ayushmk7/Dhyaan_HackMIT2026/DEMO_RUNBOOK.md

# Demo runbook — Sunday 11:00 AM

The demo beat sheet, boot order, and recovery moves. Written at 5 AM Sunday and
corrected at 14:30 after a full dress rehearsal; anything marked ⚠ needs a human
step first.

**`./demo.sh check` answers "am I ready" in ten lines.** Run it first, and again
after anything moves. `./demo.sh` with no argument lists what else it does
(`reset` between takes, `fall` without the band, `tunnel`, `survey`, `camera`).

## The demo script

0. **Camera tab → Turn the camera on.** The switch in the app really starts the
   vision worker on the hub: it opens the webcam and runs the whole cascade, and
   the pane shows the same annotated frame the hub's own window draws. Pre-warm
   it before you present (`./demo.sh camera on`) — a cold start spends ~60 s
   loading models.
1. **Drink water** → VLM logs drinking + the room. The readings under the
   picture move with you: posture, activity, eating, what it can see.
2. **Get up, change rooms** → band hears the beacons, app's location flips
   (~40 s to commit; `LOC_COMMIT_TICKS=1` halves it if it feels slow).
3. **Fall** (slap the band / drop on cushion) → app takeover opens at T+0.
4. **Cancel window lapses** (default 30 s; `CANCEL_WINDOW_S=15` for the stage)
   → **live phone call** to the demo phone. Answer, say "I'm not fine, I fell"
   or "I'm fine" depending on the beat.
5. **Resolution** → alert closes in the app, transcript visible on the alert.

## Boot order (demo machine)

```bash
./dev.sh                     # mongo -> ollama -> seed-if-empty -> API :8000
./demo.sh tunnel             # ngrok on the ONE domain the band and Twilio know
./demo.sh check              # every light green before you present
cd frontend && npx expo start
```

- `.env` at the repo root holds the Twilio/Deepgram creds; `dev.sh` sources it.
  No `.env` → API boots voice-less (stub) with no error. Check startup: a live
  boot mounts `/twilio/*` routes (`curl -s localhost:8000/openapi.json | grep twilio`).
- Seed honors `TEST_PHONE_E164` — whoever's phone is in `.env` is who Dhyaan
  calls as Asha AND as first contact.

## The band (UNO Q) — venue steps

Hand-back state (2026-09-20 ~5 AM): everything self-starts on power. On the
board: `fallband-ble.service` (host BLE scanner → `.ble_latest.json`; the App
Lab container has no Bluetooth, this feeds it), `fallband-hub-relay.service`
(bench/USB mode only, inert otherwise), bleak under `/home/arduino/blelib`.
`hub_url` is already the ngrok URL, so the band works from ANY WiFi:

1. ⚠ Join the board to venue WiFi or a hotspot (App Lab, or over USB:
   `adb shell nmcli dev wifi connect '<SSID>' password '<pw>'`).
2. Power from a wall wart or power bank. Nothing else.
3. Verify from any machine: band heartbeats show in the API log, and
   `GET /v1/residents/res_eleanor/location` moves when the band moves.

**Re-survey in final positions** — DONE at 14:15 for `kitchen` and
`living_room` (the second spot is physically the bathroom; it is surveyed under
the living-room name because that is what we call it on stage). Separation is
good: kitchen reads minor 1 at -33/-46 and minor 2 at -58; the other spot reads
the reverse, minor 2 at -26 and minor 1 at -60.

Fingerprints are written to **mongo**, so this is a one-time cost per venue: it
survives API restarts, tunnel restarts and reboots. Redo a room only if a beacon
moves:

```bash
./demo.sh survey kitchen        # 35 s, band held where that room is
./demo.sh survey living_room
```

Needs the board on USB (adb). **The app cannot do this**: the phone has no BLE
radio access, so its survey screen sends empty readings rather than faked ones,
and only the band's own scan produces real fingerprints.

## Beacons (ESP32)

- S3-BOX = kitchen (minor 1), DevKitC = bathroom (minor 2). Power via USB;
  they advertise from cold boot, nothing to start.
- Sanity from the Mac: `.venv-voice/bin/python band/tools/rssi_monitor.py`.

## Timing knobs (already demo-tuned by default via dev.sh)

| Knob | Default | Stage setting |
|---|---|---|
| `CANCEL_WINDOW_S` | 30 | 15 if the pause feels long |
| `CONTACT_WAIT_S`  | 60 | 30 |
| `DEMO_FAST` | 1 (dev.sh) | leave |
| `LOC_COMMIT_TICKS`| 2 (~40 s room flip) | 1 (~20 s) |
| `BATHROOM_THRESHOLD_S` | 90 via dev.sh | leave |

Set in the environment before `./dev.sh`.

## ⚠ Human items before 11 AM

1. ~~Keys~~ DONE. Both are set: `EXPO_PUBLIC_OPENAI_API_KEY` in `frontend/.env`
   (openers, Sunday letter) and `OPENAI_API_KEY` in the root `.env` (the
   backend's chat and written narratives). They are **two names for one key**,
   and the backend only reads `.env` at boot — after adding it, restart the API.
2. ~~Board on venue WiFi~~ DONE: it is on the phone hotspot and reaching the hub.
3. ~~Vision~~ DONE and warm. It runs on whichever machine hosts the backend, and
   it is started from the app's camera switch now, not `make vision-demo`. A
   first run on a cold machine downloads ~338 MB of weights — never let that be
   the first thing that happens on stage.
4. Phone that will be "Asha's" charged, ringer ON, Focus/DND OFF.
5. Hide Expo Go's floating dev button (shake device / dev menu) — it is the
   single most un-Apple pixel on screen.
6. Pendant CNN caveat: trained on waist-worn data; "walking" needs the
   pendant chest-high and steady. If it abstains it keeps the last label —
   say "activity classification" not "guaranteed live label" if unsure.

## Hard lessons from the all-nighter (read before rehearsing)

- **After ANY power change to the UNO Q, wait ~2 minutes** before demoing a
  fall: the Linux agent boots long after the chip chirps. Ready = a heartbeat
  in the API log. Drops during the boot window are silently lost.
- **Box I'M OK is PRESS AND HOLD (~1 second)**, not a tap — the touch and
  speaker share a wire, and the hold is what separates a finger from bus
  noise (touch v4, two confirm rounds). Say "press and hold" on stage.
- **The band is a silent sensor** — only a Movement Modulino is chained. No
  buzzer, no cancel button on the band. The BOX, app, and phone carry all
  alerting sound; cancel = box tap or app. (Chaining Buttons+Buzzer Modulinos
  from the kit adds both with zero code changes, auto-detected at boot.)
- **Demo phone: Focus/DND OFF, ringer ON.** A 5 AM rehearsal call was
  silently swallowed by iPhone Sleep Focus.
- **Box WiFi can drop on hotspot churn** — if its polls vanish from the API
  log, power-cycle the box; it rejoins on boot.
- **iOS hotspot names use a typographic apostrophe (U+2019)** — copy-paste
  the SSID, never retype it. Hotspot needs Maximize Compatibility ON (2.4GHz).
- **Drop physics**: free-fall + hard landing + LYING STILL afterwards. The
  power bank must fall WITH the pendant (pocket-worn = automatic). Handling
  bumps under ~5g no longer trigger; real drops measure 5.7-10g.
- **`lsof -ti:8000 | xargs kill` takes ngrok down with the API.** It matches
  anything *connected* to 8000, and the tunnel is. Always `./demo.sh tunnel`
  after restarting the backend.
- **The free tunnel drops about one request in five** over congested venue wifi,
  at 1-5 s each — measured. Two of four room surveys failed that way and worked
  on retry; the band and Twilio both retry on their own, so beats still land,
  just slower. `./demo.sh check` tries three times before calling it down.
- **`arduinoboards` is a trap SSID.** The board had joined it: a valid IP, a
  reachable gateway, and no route off the network, so every post died with
  `Network is unreachable` and the band looked dead. `./demo.sh check` prints
  which SSID the board is on.
- **The band's fall detection is live and sensitive** — it opened a real alert
  just from being handled. `./demo.sh reset` before you present, or the app
  opens on a takeover.
- **Never push repo config.json to the board without re-setting hub_url**
  (repo copy now carries the ngrok URL, but verify after any push:
  `adb shell grep hub_url /home/arduino/ArduinoApps/fallband-app/config.json`).

## Moving the demo host (e.g. to Ayush's machine)

The tunnel domain belongs to the ngrok ACCOUNT, not the machine — every
device (band, box, DevKitC, Twilio) follows it. No reflashing, no device
config changes. ~20 min:

1. Stop ngrok on the old machine (one tunnel per domain).
2. New machine: `ngrok config add-authtoken <Abhinav's token>` then
   `ngrok http 8000 --url subsystem-mushroom-grooving.ngrok-free.dev`.
3. Pull the repo; AirDrop the two secret files (root `.env`,
   `frontend/.env`) — never through git.
4. `cd backend && uv venv && uv pip install -e ".[vision]" --group dev`;
   docker mongo; `ollama pull nomic-embed-text` (VLM already pulled there).
5. `./dev.sh` — a fresh DB seeds Asha with TEST_PHONE_E164 and band_unoq01.
6. Fresh DB has no fingerprints: run the 2x35s room survey (above).
7. `make vision-demo` once interactively for the camera permission prompt.
8. App can run on EITHER laptop: point it at the tunnel
   (`EXPO_PUBLIC_API_BASE=https://subsystem-mushroom-grooving.ngrok-free.dev/v1`).
9. Bonus of hosting where vision runs: the fall auto-cancel's clock-sync
   caveat disappears (one clock).
10. REHEARSE ON THE MACHINE THAT PERFORMS. No exceptions.

## Recovery moves (fastest first)

- **Call never comes**: check ngrok is up and printing the SAME domain; check
  the API log for `POST /twilio/status`. Nuclear: re-run the fall.
- **Alert stuck / needs forcing**: `./demo.sh reset` closes everything open.
- **Fall won't trigger from the band**: `./demo.sh fall` takes the same path
  (it bumps the fixture's `ts` to now for you).
- **Camera pane empty**: `./demo.sh camera status` — the log path it prints is
  the only thing that tells "no webcam" from "no model pulled".
- **Room won't flip**: check `fallband-ble` is active on the board
  (`systemctl --user status fallband-ble` as arduino) and the relay file is
  fresh; re-survey if beacons moved.
- **App looks dead**: it's the backend — `curl localhost:8000/health`.
- **Voicemail picked up the call**: the ladder already treats it as no-answer
  and calls the next contact; let it ride.
