ayushmk7/Dhyaan_HackMIT2026/docs/VLM_PLAN.md

# VLM presence layer — implementation plan

Dhyaan Home, camera lane. One camera in one common room of one consented resident's home,
a local vision-language model on the Mac, and an adult child's app that gets sentences.
Three agents build this in parallel from this document. Ponytail mode: the laziest thing
that actually works, with every shortcut's ceiling named. Nothing here relaxes consent,
zone rules, or validation at a trust boundary.

Binding inputs: `PRODUCT_SPEC.md` §8 (creepiness budget), `DECISIONS.md` D-001 (family never
sees a room), `TECHNICAL_PRD.md` §6 (cascade) and §12 (privacy), `docs/frontend-DESIGN.md`.
Where this plan and the original brief disagree, §1 says so.

**Status, 2026-09-20.** This document was the build plan and is now kept as the description of
what shipped. Where the code moved past the plan the section says so inline; where the plan
specified something that was never built it is marked *specified, not built* rather than deleted.
The largest deltas since the plan was written: the person gate is an open-vocabulary detector
(YOLO-World, §3.3) and it, not the VLM, answers every structural question; the VLM is
`qwen2.5vl:3b` writing one sentence from one frame (§3.1, §3.5); the cascade runs at ~15 fps and
posts the moment what it sees changes (§3.4); posture comes from pose landmarks, not a bounding
box (§3.4); visitor detection is off by default (§3.5); there is a live monitor channel (§6.1);
the API has no authentication at all (§6.1); and the family app now shows the hub's annotated
frame over a RAM-only relay, which is a deliberate relaxation of this plan's oldest rule and is
argued where it is broken (§5.2, §5.3). The seeded resident's display name is now
*Asha* (`fa81785`, display name only; ids such as `res_eleanor` and the example sentences below
are unchanged). The `testcam/` bench this plan cites was removed in `12d53ff`; every number
from it is quoted inline here and the bench itself is recoverable at commit `56e2237`.

---
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
