ayushmk7/Dhyaan_HackMIT2026/(commit log)

2026-09-19 Product spec: regulatory correction, prior art, HackMIT logistics
    - FDA General Wellness guidance reissued 2026-01-06 disqualifies products
    with alerts/alarms for disease monitoring; automatic fall detection is
    most likely a device. Maps the three functions to three postures and
    names 21 CFR 880.2400 Class I, 510(k)-exempt as the landing spot.
    - 47 CFR 64.1200(a)(1)(ii) bars artificial-voice calls to elderly home
    lines absent emergency purpose or prior express consent -> no
    non-emergency voice feature ships into facility room lines.
    - Prior art rewritten: LifeLine (TerraHacks 2025) already does fall ->
    Twilio + LLM call. Remaining gap is one turn: calling the fallen person
    firs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
2026-09-19 Add ayushneedtodo.md; fix two PRD contradictions
    136 checkbox tasks across three lanes (backend core, voice, perception +
    intelligence), excluding hardware and frontend. Each task carries a time
    estimate and an observable done-when check. Includes a 15-minute hour-0
    list, the critical path, and a cut list ordered by what to drop first.
    PRD fixes found by the lane agents reading it adversarially:
    - Final escalation sent an SMS while the same doc excluded A2P 10DLC as
    unachievable in 24h. Ladder is now voice-only end to end.
    - DDL had no bands table despite band_offline events and /bands/pair
    needing a band_id -> resident_id mapping. Added.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
2026-09-19 Onboarding flow: welcome, consent, cold-start baseline, band pairing, room survey, escalation ladder
2026-09-19 Split TODO three ways; reconcile band interface and sensor config
    - ayushneedtodo.md (84 tasks) backend core + perception/intelligence
    - abhinavtodo.md (91 tasks) voice (Twilio+Deepgram) + React Native app
    - utsavtodo.md (62 tasks) hardware, firmware, beacons, site survey
    Each carries the shared clock, critical path, interface contract, cut list
    and demo-honesty list, plus an owner-specific hour-0 block.
    Spec conflicts found by the lane agents and resolved:
    - The two specs defined different band->backend contracts (POST /v1/events
    no-auth vs POST /v1/ingest/band with X-Band-Key). PRD wins; recorded so
    firmware does not lock the wrong format.
    - PRD 4.1 had 104 Hz / +-8 g / GPIO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
2026-09-19 Alert takeover v2 (phase-driven: countdown ring, ringing pulse, parallel contacts, final treatment, applause stat, ringtone+haptics+choreography); mock/live API switch with real §10.5 HTTP client; pu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
2026-09-19 Backend: FastAPI + MongoDB, 45 tests green
    One event collection is the only source of truth; alerts, baselines and
    chat are all readers of it.
    Working end to end against a live server:
    band POST -> event -> alert -> 30s cancel window -> call placed
    -> classified -> contact 1 -> contact 2 -> final
    - app/events.py emit() + in-process subscriber bus, full PRD taxonomy
    - app/alerts.py table-driven FSM, 16 states, escalation ladder, timers
    - app/voice.py fill-in template for Twilio+Deepgram, set_impl() seam
    - app/location.py weighted k-NN over RSSI + dwell hysteresis, never a
    confident wrong room
    - app/baseline.py robust median/MAD + Poisson surprise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
2026-09-19 Wire Abhinav's voice bridge to the real FSM
    app/voice_adapter.py implements the four functions dhyaan/voice/fsm_stub.py
    stands in for, with identical signatures, backed by the alerts FSM and
    MongoDB. Integration is one import swap plus voice_adapter.install() at
    startup; install() also points the FSM's outbound ladder at Twilio.
    A tool call the FSM legitimately refuses (classifying a call that never
    connected, or one already resolved) now returns {'ok': false} rather than
    raising into the bridge's websocket and dropping a live call.
    55 tests green.
2026-09-19 HIG polish pass: SF Symbols replace emoji glyphs (tabs + event rows), sunrise for morning bed-exit, de-prefixed event sentences, iOS body type scale + contrast, card elevation, triage expander afford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
2026-09-19 Ready-to-flash ESP32-S3 beacon sketch + per-room flashing guide (HARDWARE_SPEC §3.4, site UUID generated)
2026-09-19 Wire frontend to live backend, real LLM layer, hardware simulator
    Backend (76 tests green):
    - app/llm.py: one Claude client, returns None on any failure. Daily
    narratives and RAG answers are now synthesised and fed the resident's
    learned baseline; the medical guardrail runs BEFORE any LLM call.
    app/summaries.py adds the one-sentence triage digest a nurse reads.
    Every path keeps its template fallback - no key, no network, still works.
    - scripts/simulate_band.py stands in for the band: fall, fall --cancel,
    walk, rf, heartbeat, day, all posting the real firmware JSON with
    --dry-run to diff against real output. HARDWARE_INTEGRATION.md is the
    handover, incl. the placeholder table of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
2026-09-19 Spec feasibility pass + DECISIONS.md design log
    Add DECISIONS.md: a map of which doc owns what, decisions D-001..D-015
    with context and reasons, and owner-tagged code follow-ups (F-01..F-13).
    Specs and todo lists updated to match:
    - Family never sees a room; emergency escalation call is the one exception
    - No person contacted during the cancel window
    - FDA wording: research prototype, not FDA-cleared, cannot detect all falls
    - Recording + AI disclosure on every call; stop_recording tool; no audio stored
    - Dhyaan never dials or bridges 911; escalation is voice + push, no SMS
    - One demo script (PRODUCT_SPEC §10) with timings the system can hit;
    room tracking and walking profile move to exp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
2026-09-19 Close the remaining gaps: 11 endpoints, demo control, call transcripts
    Backend, 111 tests green (was 76):
    - 11 endpoints from API_CONTRACT_V2.md: baselines, summaries, location
    history, event-by-id, admin/simulate, bands/pair, survey start/sample/stop,
    contacts PUT, push/register. Nine frontend calls that threw
    'not available in this build' are now real.
    - /admin/simulate goes through the same ingest path a band uses, so the FSM,
    the websocket and the app behave identically to a real fall.
    - The voice stub writes real rows with transcripts and drives the FSM
    through voice_adapter. Five selectable outcomes; default is no_answer,
    which escalates - the safe direction when telephony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
2026-09-19 Connection layer (Meta challenge): family-chat plan synthesizer (Claude Opus 5, mock fallback), 'worth mentioning' openers, message-from-Eleanor card with one-tap reply, visit detection from on-devic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
2026-09-19 Remove visit detection per team decision: Dhyaan's sensing perimeter is Eleanor's home, not the family member's camera roll
2026-09-19 Her care file: care documents → medications/appointments/EMS card (Claude extraction incl. photo via vision, keyless example path, demo deep link); EMS card on the alert takeover; Dropbox challenge w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
2026-09-19 VLM presence layer: camera API, RAG fusion, redesigned app, vision worker
    208 tests green, five consecutive clean runs.
    Backend (Agent B):
    - POST /v1/ingest/camera + heartbeat, GET /camera/config, presence with
    episode dedup and a sweeper, profile_facts memory with supersession, and
    DELETE /memory that actually cascades.
    - RAG now fuses three sources into one pool with per-citation kinds:
    told (onboarding facts) / observed (camera) / pattern (narratives,
    baselines). Verified live: 'what does she usually have for breakfast'
    returns the told fact beside the observed 7:26 and 7:44 breakfasts.
    - Surveillance guard runs BEFORE retrieval and before any LLM call: speech,
    private rooms,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
2026-09-19 Merge connection lane with VLM presence; drop room-time bar from home
    Resolved four conflicts between the connection/care-file work and the VLM
    presence redesign, keeping both feature sets:
    - api.ts: kept talkAbout/latestMessage/planFromThread/sundayLetter, and the
    camera-lane chat (the only one that knows the three citation kinds).
    - settings: both 'Her care file' and the consent record.
    - home: ported her-message card, call openers and the next appointment onto
    the presence-based screen.
    - timeline: kept the activity-based version.
    Two privacy regressions the merge would have reintroduced, both deliberately
    not carried over:
    - The home screen rendered 'In the {zone}' - room-level wher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
2026-09-19 Vision worker verified on the real webcam; correct an unsafe cut
    Measured end to end on the MacBook camera against the live API: config poll
    -> consent gate -> mask -> MOG2 -> YOLO11n (MPS) -> keyframe -> RAM ring ->
    qwen3-vl:8b -> POST /v1/ingest/camera. 4 observations in 100s, all 201; the
    second crossed the dedup threshold into a real event and /presence became
    'Eleanor has someone visiting.' - no zone, no evidence retained.
    Latency, measured not estimated: 2.8s warm median for a 3-frame structured
    JSON call, 4.5-6.7s cold. Under the 6s fallback trigger, so the 8b model
    stays and 4b is not needed.
    Five things did not survive contact with the real camera:
    - qwen3-vl is a THINKING model.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
2026-09-19 VLM presence lane: local vision, fused RAG, login, onboarding
    Planned in VLM_PLAN.md, built by three agents on a frozen contract.
    208 tests green (was 111). Verified on the real webcam and a live server.
    Vision (backend/vision/, Agent A) - the only process that holds pixels:
    capture -> mask -> MOG2 motion -> YOLO11n -> keyframe -> RAM ring ->
    qwen3-vl:8b -> post-rules -> POST /v1/ingest/camera.
    No frame is written to disk or leaves the process. Fail-closed proven on
    unreachable config, missing consent, and a bedroom zone.
    Measured warm: 2.75s (8b), 2.03s (4b); 3 VLM calls per 120s in steady state.
    Backend (Agent B): camera ingest + presence dedup, profile_facts memory with
    supers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
2026-09-20 Move all docs into docs/, add a root README
    19 markdown files collected into docs/, with the four package READMEs and
    frontend/DESIGN.md renamed rather than colliding (backend-README.md,
    frontend-README.md, frontend-DESIGN.md, beacons-README.md, voice-README.md).
    Rewrote every cross-reference the move broke: ../SPEC.md -> ./SPEC.md inside
    docs/, backend/API_CONTRACT_V*.md and backend/HARDWARE_INTEGRATION.md ->
    docs/, and the spec citations in backend/app, backend/vision and the Arduino
    sketch. Verified: zero dead relative links across docs/ and the README.
    frontend/CLAUDE.md and frontend/AGENTS.md stay put - tooling reads those from
    the directory they govern and they stop working anywhere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
2026-09-20 Human redesign: native large-title nav stacks (family+staff), SF-only chrome, saturated green brand, gradient monogram avatars, person-card+feed Home, mute chrome (all explanatory captions deleted, d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
2026-09-20 Camera lane: detect food, switch to qwen3-vl:4b, one frame per call
    Latency, measured on the live webcam: 4.7-7.3s -> ~3.1s median.
    - qwen3-vl:4b instead of 8b. Benchmarked on the same frame, same prompt:
    8b warm 7.3s, 4b warm 1.7s, with no loss of description quality on a
    person-at-a-table scene. The plan called 4b the fallback; measurement
    made it the default.
    - batch_size 3 -> 1. Each extra frame is another full vision encode and
    that dominates the wall clock.
    - Frames 640x360 -> 448x252 at q70. Encoder cost scales with pixels, and
    448 is ample to see a person, a table and a sandwich.
    Food detection, which never worked before:
    - The schema only asked for plate_or_cup_present. A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
2026-09-20 Structural de-slop: one repeated MetricRow species (Health anatomy: tinted glyph+label, black datum, gray metadata) replaces bespoke widget-posters; Health-sheet category hues; neutral systemGrouped 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
2026-09-20 Camera lane 7.3s -> 2.4s: smaller model, and stop paying for the schema
    Model, benchmarked on the same live frame, warm:
    qwen3-vl:8b 7.30s
    qwen3-vl:4b 1.95s (spends tokens on a <think> preamble)
    qwen2.5vl:3b 0.69s <- shipped, 3.2 GB
    moondream returned nothing usable on this schema
    Then measured where the rest of the time actually went:
    long prompt + schema 1.54s <- what every call used to do
    long prompt, no schema 0.14s
    short prompt + schema 1.24s
    Ollama's structured-output constraint costs ~1.4s per call and was most of
    this lane's latency. Prompt length was irrelevant - 931 chars bought nothing -
    so shortening the conditioning would have been the wrong fix.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
2026-09-20 Camera lane 7.3s -> 18ms: YOLO answers the structural questions, not the VLM
    The architecture was wrong, not the model. A 3B VLM was being asked to count
    people and spot a cup - detection problems - at ~1120ms a call, while a YOLO
    model already in the pipeline does both in ~6ms and does not hallucinate a
    sandwich.
    COCO already covers all four things we need:
    person / visitor person class, count >= 2 = visitor
    food sandwich, pizza, banana, apple, orange, cake, donut,
    hot dog, broccoli, carrot
    objects cup, bowl, bottle, wine glass, fork, knife, spoon,
    dining table, chair, couch
    posture bbox aspect ratio, v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
2026-09-20 Port beacon sketch to NimBLE-Arduino 2.x (NimBLEBeacon removed; hand-built iBeacon frame); compile-verified on DevKitC and S3-Box targets
2026-09-20 Single occupant by default; lightest detector; env-tunable cadence
    Visitor detection is now opt-in (VISITOR_DETECTION=1) and the person count is
    clamped to one. In a real home a second person is the most important fact on
    screen. In a hall, an office, or a hackathon table it is true of every single
    frame, so 'Eleanor has someone visiting' fired every 20 seconds and drowned
    eating, walking and everything else worth saying. The detector still sees
    them; the product just stops treating the room as the subject.
    Measured on the live webcam with yolov8n: 13ms median, 7 of 12 observations,
    person_count 1 on every frame, and the app reading 'Eleanor is up and moving
    about.' Three people holding a s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
2026-09-20 Fix: _detect assumed an opened camera on the synthetic source
    self.cam is opened in run(), so a Worker constructed but not started - every
    test, and --dry-run before the first frame - has none, and _detect threw
    AttributeError on self.cam.script(). Two tests on main were red because of it.
    242 tests green.
2026-09-20 Add fallband Linux agent and close the hardware software gap.
    MCU fall cascade already existed; this adds App Lab python/main.py
    (Bridge→ingest/cancel/heartbeat/rf), config, bring-up scripts, RSSI
    monitor, fixture-shape tests, and logs D-016–D-020 so a real band can
    post once hardware is flashed.
    [detector.h, i2c_scan.ino]
2026-09-20 Harden fallband for Movement-only bring-up and cushion drops.
    Make Buttons/Buzzer optional, pin Modulino sketch deps so App Lab compiles,
    loosen post-impact stillness for firm-cushion demos, and reload hub_url/band_key
    when config.json changes. Ignore the generated App Lab zip.
    [sketch.ino]
2026-09-20 The lag was the rate limit, not the detector: post on change
    min_gap_s held two keyframes 6-20s apart. That was right when every
    observation cost ~2.4s of model time; it is nonsense now the detector answers
    in ~13ms, and it WAS the whole perceived lag - the app sat six seconds behind
    a camera that already knew.
    The detector now posts its own observation the moment what it sees changes
    (person count, food, dishes, posture band), and the keyframe selector keeps
    its slow cadence for the VLM alone.
    Measured on the live webcam, gaps between observations:
    before [6, 1, 6, 11, 6, 8, 3, 13, 18] median 6s
    after [1, 0, 1, 0, 1, 0, 0] median 0s
    Detector median 14ms, and the app read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
2026-09-20 Faster again: the cascade was sampling 1 frame in 10
    Profiled the loop instead of the detector, and the detector was never the
    problem:
    camera read 33.4ms (30 fps, normal)
    frame sampling every 10th -> ~3 fps <- the bottleneck
    detector 14ms
    ingest POST 3.1ms (blocking the loop)
    preview window 11.6ms (only with --preview)
    sample_every_n=10 meant up to 333ms passed before a change was even looked
    at. Now 2, so the cascade runs at ~15 fps against a 33ms camera interval,
    which the 14ms detector and 3ms post fit inside comfortably.
    The detector's own posts also moved off the loop onto one worker thread with
    a bounded queue, drop-oldest. 3ms is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
2026-09-20 testcam: benchmark seven detectors, and answer why food fails
    Why food fails: COCO has exactly ten food classes - sandwich, pizza, banana,
    apple, orange, cake, donut, hot dog, broccoli, carrot. A crisp packet, a
    noodle box, a mug of soup, a bowl of cereal are all invisible to every YOLO
    variant, which is why swapping n/s/m changed nothing.
    Measured on the live webcam, 448x252:
    ultra-coreml 6.9ms
    apple-vision 7.1ms native, honestly reports food=[]
    ultra-pytorch/mps 7.4ms current baseline
    onnx-yolo/coreml 9.7ms ~40% slower than PyTorch, same weights
    yolo-world-s 10.2ms open vocabulary
    clip-zeroshot 13.0ms
    mediapipe-tasks 23.4ms
    YOLO-Wor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
2026-09-20 AMD: only beep-confirmed verdicts trigger voicemail flow (machine_start false-positived on a live human); fix TwiML stream URL to include /twilio/stream path
2026-09-20 Stop showing the family the machinery
    Six things the backend was saying out loud that were written for a log file,
    found by reading what the API actually returns rather than what it intends to.
    Chat was citing the escalation ladder to the family. `call_placed`,
    `escalation_*`, `voice_response_classified`, `feedback_given`, `profile_updated`
    and `memory_deleted` were all retrievable, so Ask could answer with
    "[SIMULATED CALL - no telephony wired up] Called contact_final +1555..." under
    the label "Dhyaan saw". They join FAMILY_EXCLUDED_TYPES. The test asserts both
    halves: the noise is gone AND the real observation still comes back, because a
    filter that swallows everything passes a one-sided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
2026-09-20 The data layer stops leaking rooms and throwing away transcripts
    `talkAbout` and `sundayLetter` read `GET /residents/{id}/timeline` — the STAFF
    feed, raw `embedding_text` with zones attached ("Eleanor moved into the
    bathroom", "Band band_a3f2 reported fall_suspected"). They posted it to Claude
    and rendered the result onto Today and into her weekly letter. That is
    whereabouts on a family surface, sent off-device first, which is exactly what
    D-001 exists to prevent. Both now read `/activity`, which the server has already
    run through its family filter.
    `toCallRow` read `payload.role` and hardcoded `transcript: []`, so every call
    rendered as role "staff" with no words and the takeover's "What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
2026-09-20 One app again: surfaces carry their own colour
    Five agents restyled screens against the design system in parallel and drifted,
    as five agents do. The same idea was built three ways: bespoke Views where Card
    existed, hand-rolled section headings, `rgba(255,255,255,0.55)` scattered
    through dark screens, a blue-tinted pressed state on grey chrome, radius chosen
    by taste.
    The fix is a surface context rather than a style guide nobody reads. `Screen`,
    `Card`, `Slab` and `StatTile` declare what they are, and `Txt`, `Rule`,
    `DataLabel` and `Marquee` read their colours from it. On an ink slab or an
    alarm screen you now delete `tone="white"`, `color={WHITE}` and every `night`
    prop — they stop being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
2026-09-20 dev.sh: make Ask answer, and make the timeline move
    Two defaults that turn a technically-working demo into a watchable one, both
    overridable.
    `CHAT_FALLBACK_MODEL=qwen2.5vl:3b`. With no ANTHROPIC_API_KEY, rag.py stitches
    the retrieved sentences into a labelled list — correct, but it does not answer
    the question. Pointing the fallback at the vision model, which the camera lane
    has already pulled and keeps warm, gets real prose out of the same Ollama for no
    extra download: "Yes, she has eaten today. She had dinner at the table around
    7:10 pm." A stale note in .env.example claimed the 3b was not a substitute for
    qwen3-vl:8b; that predates the camera lane moving to the 3b, and it is wrong, so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
2026-09-20 Food it can actually see, and posture that stops inventing falls
    FOOD. COCO's ten classes could not see a crisp packet, a protein bar, a mug
    of soup or a bowl of cereal, which is the whole reason food detection never
    worked. YOLO-World now runs on the keyframe path with a 16-word vocabulary;
    COCO stays on the hot path so the 15 fps loop is untouched.
    crisp packet COCO: nothing -> food
    protein bar COCO: nothing -> food
    cereal bowl COCO: bowl only -> food + plate
    noodle bowl - -> food + bowl
    End to end through the API, keyframes posted food_visible=true with evidence
    "one person, food in view" where COCO alone said bowl-and-no-food. A live
    webcam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
2026-09-20 Wire live voice into the backend: bridge mounted, stub swapped, adapter completed
    - main.py mounts dhyaan/voice/bridge and installs the Twilio impl when
    TWILIO_ACCOUNT_SID + DEEPGRAM_API_KEY are present; zero-config dev unchanged
    - bridge.py grows use_fsm() and a coroutine-tolerant _fsm_call so the same
    code drives the sync stub in tests and the async adapter in production
    - voice_adapter.py completes the FSM surface the bridge needs: CALL_BINDINGS,
    advance_no_answer (voicemail is not an answer), force_ack, leave_message ->
    family_note event; event names mapped into the backend taxonomy and webhook
    handlers never 500 on a bad event
    - dev.sh sources .env so creds reach the API; seed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
2026-09-20 Blue, white and black, and a dark mode that is actually reachable
    The palette collapses to one accent plus the greys between white and black. The
    hard part was not recolouring: the app encoded MEANING in hue — moss=OK,
    rust=alarm, ochre=worth a look, amber=the camera, hue.* per data category,
    zoneColor per room — and one accent cannot say six things. So the taxonomy is
    replaced rather than repainted:
    alarm inversion. The takeover is drawn in the opposite scheme, and the
    alerting tile, chip and dot are the only inverted things on an
    ordinary screen. It reads louder than red did and costs no hue.
    OK no colour at all. A hollow ring, a quiet wash,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
2026-09-20 on_floor never reached the activity field, and evidence overclaimed
    vlm.from_scene has on_floor and lying_down in its vocabulary but emitted
    neither: posture on_floor fell through to the final else and was reported as
    "sitting". A correctly detected fall would have been logged as someone sitting
    down. Found by lying on the floor in front of the camera and seeing 60 of 60
    observations say sitting.
    on_floor now has its own branch, ranked ABOVE food on purpose - someone on the
    floor holding a sandwich is on the floor, not eating.
    Also: with posture unknown (knees occluded, or no landmarker) the evidence
    string still read "one person, seated". She is present and neither upright nor
    on the floo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
2026-09-20 Follow one subject, so leaving the frame is not read as sitting
    The subject was whichever person had the biggest box, recomputed every frame.
    With more than one person in the room that silently hops: the resident lies
    down or steps out, a visitor becomes the biggest box, and the system reports
    her as present and sitting. Nothing looks wrong. It is watching someone else.
    Found by lying on the floor in front of the camera and getting 60 of 60
    observations saying "sitting" - a second person was in shot the whole time.
    gate.pick_subject now follows the box that overlaps the one we were already
    watching (IoU >= 0.2), and returns switched=True when nothing does. A switch
    means our subject is gon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
2026-09-20 Preview shows the decision, not just the picture
    The window drew one box and a status line, so it could not answer the only
    question you ask it: is it seeing this? A hopping subject looked identical to
    a steady one, and posture, activity and food were invisible.
    It now draws every person - the one we are following in green and labelled
    "subject", anyone else in grey - and prints two lines:
    activity walking posture upright
    people 2 food - objects -
    Verified against the app at the same moment: posture upright -> activity
    walking -> "Eleanor is up and moving about." The whole chain is legible from
    the window now.
    284 tests green.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
2026-09-20 Food and drink on the hot path, throttled to every 3rd frame
    Open vocabulary ran on the keyframe path only, so food was invisible for the
    seconds between keyframes - which is exactly when someone picks up a bottle.
    It now runs whenever a person is in view.
    Every frame was too much: the open-vocab pass fights the resident 3B VLM for
    the GPU and latency spiked to 824 ms and 2702 ms. Every 3rd frame is 5 food
    checks a second at 15 fps, and food does not change in 200 ms:
    every frame median 10 ms, but spikes to 824 ms and 2702 ms
    every 3rd median 12 ms, p90 14 ms, max 15 ms
    Verified on the real fixtures:
    protein bar COCO: nothing -> food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
2026-09-20 Titles up, one type scale, Today is a dashboard, no dark grounds
    Everything the user asked for in two passes, plus the one thing that made the
    first pass wrong.
    **Titles up and centred.** Every tab stack used iOS's big left-aligned title,
    which eats 50-90pt before a single row of content. Now compact, centred and
    translucent, with the blur following the app's own scheme rather than the OS so
    a dark app never gets a light bar. `headerLargeTitle` is deprecated in favour of
    `headerLargeTitleEnabled`; both were checked against the installed SDK 57 types
    rather than guessed. With Screen's padding and Marquee's section gap trimmed
    too, a tab screen's first row sits about 60pt higher.
    **One type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
2026-09-20 Band: host-side BLE relay + survey driver (App Lab container has no Bluetooth)
    App Lab runs fallband in a Docker container without bleak or the D-Bus
    socket, so every in-container BLE scan silently returned [] — room
    localization was dead on-device. All changes [claude]-marked:
    - host_ble_scand.py (new): scans on the UNO Q host Linux where BlueZ works,
    writes .ble_latest.json into the app dir the container bind-mounts;
    installed as user unit fallband-ble.service (linger already on, so it
    survives reboot and needs no tether)
    - ble_scan.py: scan_ibeacons_sync prefers the relay file while fresh (<30s),
    falls back to direct bleak scanning elsewhere (Mac-as-band unchanged)
    - survey.py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
2026-09-20 Light only, and actually light this time
    A dark plate was still showing on the home screen. The Slab there resolves to
    `inverse`, which is `blue[200]` in the light scheme, so it was light — but
    `app.json` said `userInterfaceStyle: "automatic"`, and a phone set to dark got
    the whole dark scheme: ground `#0B0F16`, that Slab navy `#0F2C66`. The previous
    commit read "remove all the dark mode background things" as "stop using dark as
    a design device" and kept scheme support. That was the wrong half.
    Fixed in two places, because one is not enough: `app.json` back to `"light"`
    covers iOS, and a `ThemeProvider scheme="light"` at the root covers Android and
    web, which still report the system schem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
2026-09-20 Make it usable: real touch targets, honest errors, no darkness left
    The strip-back left the app clean and cold. Buttons had become inline text
    links, cards had lost their edges, and the affordances went with them: things
    that opened no longer looked like they opened. This is the pass that makes it
    operable rather than merely tidy.
    **Touch targets.** `Btn kind="link"` was ~28pt and `Chip` ~30pt, both padded out
    with hitSlop. Both are a real 44pt now. An invisible hit area fixes a mis-tap;
    it does not fix a target that looks too small to aim at, which is the actual
    problem when someone is checking on their mother one-handed at 3am. Onboarding's
    answer chips, room chips and confirm chips went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
2026-09-20 Shut the camera lane down cleanly, and stop lying about it afterwards
    Three faults, one of them serious.
    1. SIGTERM killed the worker where it stood. pkill, a supervisor and macOS at
    logout all send it, and Python's default action is immediate death, so the
    finally block never ran: the camera was never released, posture.close() was
    never called, and the "offline" heartbeat was never sent.
    2. Because that heartbeat never arrived, the backend kept reporting
    camera.online: true with the last sentence frozen in place. Verified before
    the fix - worker killed, app still said "Eleanor has been settled since 2:30
    am - sitting, by the look of it." That is this product looking like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
2026-09-20 Band: pace survey loop for the relay path, single-advert host scans
    [claude]-marked: survey.py sleeps 2s per pass (relay reads return instantly
    - one run spun 270k empty passes); host_ble_scand.py accepts single-advert
    beacons per 6s window (min 3 caused minute-long blind stretches). Board also
    carries two enabled user units now: fallband-ble (host BLE scanner) and
    fallband-hub-relay (bench-mode USB forwarding, inert on WiFi).
2026-09-20 S3-BOX boxassist firmware: beacon + on-box 'Are you OK?' alert response
    [claude]-marked new sketch (beacons/boxassist/): keeps the identical kitchen
    iBeacon frame advertising, joins WiFi, polls GET /v1/alerts every 2s, and on
    an open alert takes over the screen — tap or BOOT button acks via
    /demo/force_ack. Beacon-only fallback when WiFi is unconfigured; beacon.ino
    untouched as the proven fallback firmware. Compiles at 30% flash
    (LovyanGFX autodetect: original BOX and BOX-3 both handled). Not yet
    flashed - needs the box on USB.
2026-09-20 No auth, no invented people, and a detector that can name food
    Three things the demo needed.
    **Authentication is gone, entirely.** The login screen, `POST /auth/login`, the
    `users` collection, the `Bearer` and `X-Band-Key` guards and the websocket token
    are all deleted. `main.py` now opens with a notice saying plainly that anything
    which can reach the port may read every resident's history and post observations
    as any camera, because someone will read this later and should not have to infer
    it. Test count 284 -> 263: the 21 removed are exactly the auth tests.
    The line that mattered while doing it: **consent gates are not auth.** The
    camera ingest still fails closed on consent off, on a pau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
2026-09-20 Stop the 338 MB CLIP re-download, and let the VLM actually speak
    CLIP. ultralytics' fork verifies ViT-B-32.pt by SHA256 and silently
    re-downloads on a mismatch. Ctrl-C a slow first run and the partial file stays
    on disk, so every launch afterwards blocks on 338 MB before the camera even
    opens - observed here, and on venue wifi it is a dead demo. openvocab now
    checks the hash itself, deletes a corrupt checkpoint instead of letting it
    poison every future start, and says plainly when a download is coming.
    That needed a new exception in the no-filesystem guard, whose docstring asks
    for the argument rather than a one-line edit. The argument: the rule defends
    "no FRAME is written to disk", and ha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
2026-09-20 Silence MediaPipe's telemetry uploader
    MediaPipe ships a Google "clearcut" usage uploader that fires on load. Ours
    logged it four times a run:
    E0000 portable_clearcut_uploader.cc:90] Failed to send to clearcut:
    FAILED_PRECONDITION
    It never succeeded, and what it would send is library usage rather than
    anything from a frame - no image reaches it. But it TRIES, and this product's
    whole claim is that nothing about the resident leaves the machine. An outbound
    attempt nobody asked for is not ours to wave away, and a judge grepping the
    logs of a privacy-first eldercare product should not find a Google telemetry
    line in it.
    No documented off switch in 0.10.35, so it is denied a des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
2026-09-20 Rename the resident: Eleanor -> Asha (display name only)
    Consistent with Priya and Sam. Internal ids untouched everywhere
    (res_eleanor, band ids, API paths) — only what people see and hear:
    seed display_name + narratives, voice-agent default, VLM worker fallback,
    runbook. Live DB reseeded (fingerprints preserved); frontend copies land
    with the walkthrough agent's commit.
2026-09-20 Box speaks, DevKitC becomes the bathroom help point
    [claude]-marked firmware additions:
    - boxassist: spoken alert prompt ('Asha, are you okay?', 16kHz PCM in
    flash), chime every 10s while open, confirm tone on ack. ES8311 playback
    driver trimmed from espressif/esp-bsp; I2S via core ESP_I2S; BOX vs BOX-3
    WS pin picked at runtime; codec failure degrades to silent, never crashes.
    Flashed to hardware and beaconing verified on air.
    - bathhelp (new, replaces beacon.ino on the DevKitC): identical minor=2
    iBeacon frame + WS2812 status LED (red pulse while an alert is open) +
    BOOT long-press posts button_pressed as a bathroom help call. Compiled,
    not yet flashed.
    [bathhelp.ino, box_audio.h, boxassist.ino, es8311_min.h]
2026-09-20 Espressif submission: the boards are active care nodes now, and it's proven on hardware
2026-09-20 Stop the app hanging on "Checking on Eleanor…"
    Two defects, one symptom: Today sat on its loading state forever with nothing in
    the logs.
    **`request()` had no timeout.** React Native's `fetch` has no default deadline,
    so a host that never answers leaves the promise pending, React Query stays in
    `isPending`, and the screen shows its loading state for good. There is no error
    path because nothing ever rejects. Ten seconds now, and the message names the
    address it could not reach: "Couldn't reach Dhyaan" without the URL tells nobody
    which of four plausible causes it was.
    **The default API base was `localhost`, which is wrong on a phone.** On a device
    in Expo Go, localhost is the phone, not t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
    [beacon.ino, boxassist.ino]
2026-09-20 App walkthrough: nine fixes against the live backend
    From the screen-by-screen live-data audit (all gates green):
    - restore Authorization header + ws token (harmless on no-auth builds,
    essential against a keyed backend) — the app was fully dark without it
    - resolved alerts show the call transcript ('What the call heard')
    - chat answers scrubbed of raw event ids and machine log-line citations
    - room names no longer leak onto family surfaces (D-001) — scrubRooms on
    event detail, chat, citations
    - camera console controls no longer hidden under the floating tab bar
    - baseline label suffix fix, dead-alert plate redirect on lost route param
    - user-visible Eleanor -> Asha across mock data a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
2026-09-20 Tune fallband for cushion demos and make alert ladder timers env-driven.
    Loosen still/orient and shorten rearm/grace for venue drops; load RETRY/RESIDENT timeouts from .env so the hub can run a snappy demo ladder.
2026-09-20 Remove testcam
    The bench did its job: it proved COCO's ten food classes were why food
    detection failed, that YOLO-World fixes it for ~4 ms, that CoreML and ONNX and
    MediaPipe do not beat PyTorch/MPS on this machine, and that the bbox posture
    heuristic called someone at a desk on_floor on 20 frames of 20. All four
    findings are now in the shipped code and its comments, so the harness is dead
    weight - 1.4 GB of venv and model downloads for numbers we already acted on.
    Every comment that cited testcam/FOOD.md now cites the commit instead, so
    nobody goes looking for a directory that no longer resolves. The numbers
    themselves were always quoted inline; only the file that produced them is
    gone, an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
2026-09-20 Band: impact-only falls escalate instead of dying in a log line
    The 'hub rejects impact_only until A5' gate was stale — BandEventIn accepts
    free_fall_ms=0. Real falls (slumps, pendant-worn collapses) often have no
    clean free-fall window; detected-but-discarded was the worst option when the
    cancel window and Button A exist to absorb false positives. [claude]-marked;
    compat.impact_only_local_only=true restores log-only. Band tests green.
2026-09-20 Documentation matches the code again, and the last hardcoded name is gone
    Roughly 1,700 lines across nine documents, each claim checked against the
    source rather than against the previous draft. The instruction to all three
    passes was that a confident document which is wrong is worse than one admitting
    a gap, so anything specified and never built is now labelled that way instead
    of being quietly deleted.
    The corrections that matter: every auth section was fiction (no login, no
    Bearer, no band key, no websocket token), and each document now states
    separately and loudly that the consent gates are untouched, because a reader
    who sees "no auth" will otherwise assume "no checks". The camera lane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
2026-09-20 Band: ff_max_ms 400 -> 700 - the detector was rejecting standing-height falls
    400ms of free-fall is a 45cm drop. A standing person's chest falls ~1m
    (~450ms), so the 'longer free-fall = hand dropped the gadget' gate was
    discarding the most important fall there is. 700ms (~2.4m) keeps the
    throw-off rejection while letting real collapses through; stillness,
    orientation, and impact gates still filter false alarms.
2026-09-20 Band: close the silent-drop kill chain (audit findings 1+2)
    impact_g_after_ff 2.8 -> 2.2 and drop_latch_ms 1000 -> 0: a drop whose
    landing peaked under 2.8g parked the detector in FREEFALL until timeout,
    armed the 'dropped gadget' latch, and swallowed the impact with zero wire
    traffic — the one failure mode the impact-only escalation cannot see. The
    latch's rationale is obsolete (not-worn impacts escalate now). grace_seconds
    15 to match the stage CANCEL_WINDOW_S so attempt two isn't a 34s wait.
2026-09-20 Band: impact_g_soft 3.5 -> 5.0 - separate drops from handling
    Measured tonight: real drops land 6.3-10g, handling bumps 3.6-5.7g. At 3.5
    one drop-test session opened four alert ladders. 5.0 keeps every real drop
    firing with margin while ending the hair-trigger; the free-fall path keeps
    its own 2.2g bar. Re-tune against calibrated hardware post-hackathon.
2026-09-20 Home stops reshuffling, Ask becomes a conversation, screens get room, OpenAI everywhere
    **Why the home screen reformatted itself while nobody touched it.** The cause
    was the server, not the layout. The camera worker posts two or three
    observations a second, and `_push_presence` broadcast `presence.update` on
    every one. Each push carried a `last_observation_at` that had moved, so the app
    saw a new presence object constantly: Today re-rendered at that rate, its hero
    re-mounted and replayed its entrance because it is keyed on the sentence, and
    rows that appear only when they have something to say flickered in and out.
    Presence is now pushed only when something a person could see has changed:
    s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
2026-09-20 Band: apply hardware-audit FIX-NOW items (F2,F4,F5,F6,F7,F8) + audible escalation
    - F2 self-healing thresholds: heartbeat_tick verifies MCU config rev and
    repushes on drift (a power cycle silently reverted to compiled values)
    - F4 loud stub-bridge warning when running on real hardware
    - F5 spool moved to the bind-mounted app dir - falls survive container restarts
    - F6 stale cancels can no longer wedge the spool drain behind them
    - F7 rssi clamped to hub bounds - one weak beacon no longer 422s a whole scan
    - F8 f_min pushed under the name the MCU actually parses (f_min_g)
    - impact-path falls trigger signal(2): long low tone IF a Buzzer Modulino is
    chained (this unit has Movement only - th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
2026-09-20 Bathroom help button opens the ladder (kind=button)
    button_pressed from the band/bathhelp point used to be logged and discarded.
    A deliberate press for help now gets the same critical ladder as a fall -
    a help button that only writes a log line is worse than no button.
2026-09-20 The home screen stops rewriting its own sentence
    The first fix stopped presence being PUSHED on every observation. It was still
    changing, because the sentence itself was genuinely different each time. Two
    causes, both in how presence was derived.
    **An uncertain frame rewrote the whole sentence.** `apply_presence` rebuilt
    `spot`, `activity` and `posture` from each raw observation, and the detector
    returns "unclear" whenever it cannot tell from that particular frame, which on a
    live camera is every few seconds. So the family's one sentence flapped between
    "settled since 5:34", "settled at the table since 5:34" and back, with different
    wording and different length, reflowing the screen. Presen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
2026-09-20 Alerts carry the room: takeover and phone call say where she fell
    open_alert snapshots the resident's current zone (same source as the
    location endpoint, ignored when >30 min stale) onto the alert doc — the app
    gets it for free via _ser, and the voice adapter folds it into the fall_time
    phrase so every call script says 'a possible fall at 5:12 AM in the kitchen'
    with zero prompt-template changes.
2026-09-20 A bigger title, a scannable Her day, and a Camera page that reports
    **Title.** The bar title read 17 beside a round header button and looked like
    the button's caption. It is 22 now, the next step on the scale, which puts its
    cap height at about half the disc so the two sit level. Kept at label weight
    rather than title weight so a bar title does not compete with the section
    headings inside content, which are also 22. Onboard had been inheriting UIKit's
    default and needed the explicit read, or the app would have shipped two title
    sizes.
    **Her day was a wall.** The complaint was exact: every block looked the same and
    they touched each other, so there was nothing to keep your place with. Three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
2026-09-20 On-device gait metrics: pendant computes cadence + stride regularity, hub baselines it
    Band ([claude]-marked): step detector enabled, 60s gait windows (>=10 steps)
    summarized on the pendant's Linux side - cadence, step-interval CV, impact
    consistency - riding the existing heartbeat as an optional key. Raw IMU never
    leaves the device. Hub: gait_summary event type, heartbeat ingest persists it,
    baseline feature gait_cadence_spm (alerts on slower-than-usual only) with
    family copy. No new routes, no new trust boundary. Band+backend suites green.
2026-09-20 Camera keeps only pause; tab glyphs come down a step
    **The simulate controls are off the Camera page.** Meal, Visitor and Out of view
    were an on-stage fallback for a sulking webcam, and they were sitting in the
    family's own floating bar. A family screen should not offer to invent
    observations about her. `POST /admin/simulate` is untouched and the debug panel
    in Settings still reaches it, so the fallback is not lost, only moved off a
    surface where it did not belong. Pause and Resume stay, which is what that bar
    is actually for.
    **Tab glyphs 22 to 20**, via one constant so the five cannot drift apart. They
    sat slightly heavy against their labels.
    Worth recording, because it changes what an e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
2026-09-20 A failing call no longer stops the ladder, and one alert takes one path
    Two ways an escalation could quietly stop escalating, both found by reading
    the ladder rather than running it, both now covered by a test.
    **A failing action cost the alert its clock.** `_schedule()` was the last
    statement of `_call_resident`, `_call_contact` and `_final_escalation`, so
    anything raising before it — a Twilio call that will not place, a contacts row
    with no `phone_e164`, which lines 97 and 115 indexed unguarded — aborted the
    action after `_apply` had already written the new state. The timer task's
    `except Exception: print(...)` ate the traceback. The alert then sat in
    CALLING_RESIDENT for ever: the ap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
2026-09-20 VLM fall guard: camera evidence auto-cancels inside the window, never blocks opening
    fallcheck.py subscribes to the event bus: a camera-sourced upright/moving
    observation (posture upright, conf >= 0.8, timestamped after the trigger +2s
    guard) during LOCAL_CANCEL cancels the alert by='camera' with a
    fall_autocancelled audit event. Fail-closed everywhere: low confidence,
    stale evidence, no camera, window already past - nothing changes. Design
    choice over 'don't fire': a wrong-but-confident camera can never eat a real
    fall; the family-visible outcome (no calls) is identical. 7 new tests; suite
    at 237 green (2 known openvocab cv2 failures).
2026-09-20 On-device neural activity classifier: CNN on the pendant, 94.9% held-out
    Plan A shipped: MCU streams 52Hz accel over the Bridge (pattern from
    Arduino's own real-time-accelerometer example, 208Hz fall loop untouched,
    stream_accel kill switch), Linux side runs a 2-conv 1D-CNN trained on
    UCI-HAR raw signals in PURE NUMPY (87KB weights, no ML runtime, torch
    parity 1.2e-07). Majority-voted walking/sitting/standing/lying label rides
    the heartbeat; backend stores it and emits edge-triggered
    activity_classified events - deliberately NOT activity_observed, so the
    band's own label can never feed the camera's fall auto-cancel. Chest-vs-
    waist placement caveat documented. Band suite green; backend 239 g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
2026-09-20 Four screens read the way Her day does: grouped, spaced, in her name
    Settings was one continuous slab of rows. It is now four plates under
    quiet headings, the same pattern Her day uses: hairlines inside a group,
    real air between groups, so the eye can find where a run ends. The
    groups are what a family member is actually deciding between, not what
    the code is organised by: what Dhyaan was told, what she agreed to, when
    something happens, her records. Two row titles shrank because they now
    sit under a heading that already said half of it.
    No fixed left gutter here. Her day can afford one because every row's
    left value is a time; these labels are sentence-length, and a gutter
    wide enough for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
2026-09-20 Sustained-lying watcher ships dark (LYING_WARN_S=0 default)
    The lying label alone cannot tell a collapse from a couch nap or a pendant
    on a table - and the pendant WILL be on a table before the demo. Detection
    code stays (tested, armable by env for a controlled walkthrough); turning
    it on responsibly means camera corroboration, the same fusion falls use.
2026-09-20 Her day's filters fit on one line
    Five filters wrapped onto a second line on every phone narrower than a
    Pro Max, mostly because one of them was three words. They are one word
    each now, the row's sides are tighter, and each chip gives up width in
    proportion instead of pushing the last one off the edge.
    "Out and about" is "Out". The sentence it feeds still reads: "Nothing
    filed under 'Out' today."
    Nothing else moved. The chips keep the page's pill shape, the accent
    fill on the selected one, and their 44pt height, so the target is still
    a thumb's. The one-line clamp is scoped to this row; the Ask screen's
    suggestion chips are whole questions and still wrap.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
2026-09-20 The camera's readings drop the engineer's numbers
    FPS, LATENCY and BATCH were on the family's camera screen because they
    were in the monitor tick, not because anyone reading that screen can do
    anything with them. "2596 MS" tells a daughter nothing about her mother.
    Six readings left, and each is something a person could act on: the gate
    and the person count say what it is looking at, ACTIVITY and CONF say
    what it thinks it sees, TICK AGE says whether the feed is live at all,
    and MODEL is the claim that this runs on the laptop in the room rather
    than in someone's cloud.
    The tick still carries the dropped fields; only the screen stopped
    showing them.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
2026-09-20 Her name starts on the same line as everything under it
    Settings put her name at the screen's own padding while every heading
    and every row below it sits sp(4) further in, on the plates' text edge.
    The name was the only thing on the screen starting 16pt to the left of
    the column, which read as a mistake rather than as a hierarchy.
    Same inset now. One vertical line down the page.
2026-09-20 The four figures all sit on one line
    Each figure gets a quarter of a phone's width, which is about one word
    at the caption step. "Minutes seen" and "Up at night" wrapped, so two of
    the four columns were a line taller than the other two and the plate
    read as broken rather than as the labels being long.
    "Minutes" and "Night ups" now. The label is clamped to one line, so a
    longer word added later truncates instead of quietly reintroducing the
    same ragged plate.
2026-09-20 Box phantom-press fix + final UI sweep (7 fixes, all screens ship)
    Box: GPIO0 doubles as the panel's SPI MISO on the original S3-BOX - the
    display holds the line low, which read as an eternal BOOT press and silently
    acked EVERY alert ~10s after open (by=box_kitchen, nobody touching it).
    Physical-button confirm now compile-gated off; touch is the confirm input.
    UI (agent sweep, every screen screenshot-judged on live data): alert
    takeover no longer traps after an external ack clears it; machine voice
    scrubbed from sentences ('res_eleanor ... (simulated)' -> 'She ...'); chat
    citations humanized; staff deviations in hours not seconds; care-file typo;
    chat hero scroll fix; activity_classified ro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
    [boxassist.ino]
2026-09-20 Box: 3-sample touch debounce kills the phantom self-ack
    The ES8311 codec shares I2C with the touch controller; audio traffic during
    the spoken prompt corrupted single touch reads into phantom taps - the box
    acked every alert ~6-10s in, untouched (by=box_kitchen). Bus garbage never
    repeats 3 consecutive in-region samples 40ms apart; a real finger does.
    Validated live: alert survives the window and escalates to the call.
    (Matches the binary flashed at validation time.)
2026-09-20 Box touch v3 (audio-yield confirm) + voice silence handling that actually hangs up
    Box: v1 single-read phantom-acked during audio (shared I2C); v2's 3-clean-
    consecutive-reads ate REAL taps for the same reason. v3: first plausible hit
    silences the audio (frees the bus), then 4 clean reads decide - hold half a
    second to confirm. Chime period 10s->20s for more quiet windows. Flashed.
    Voice: silence timeout 20s->10s (env SILENCE_TIMEOUT_S); second strike now
    SPEAKS its exit line before hanging up - the old path set pending_hangup
    with no audio to finish, so the call dangled forever; 8s force-hangup
    backstop; prompt bans 'I didn't catch that'. Bridge tests 12/12 (re-applied
    grace monkeypatches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
    [boxassist.ino]
2026-09-20 Docs match tonight's reality: no more lies a teammate could trip on
    - fallband README: hub_url is the ngrok URL (not Mac LAN IP), band_key is
    ignored (auth removed), impact_only ESCALATES (was 'logged until A5')
    - bringup.md: 2.4GHz Maximize Compatibility + copy-paste the SSID (U+2019)
    - runbook: box confirm is PRESS AND HOLD ~1s; vision runs on whichever
    machine hosts (proven on Abhinav's); Focus OFF / Expo dev button / CNN
    placement caveats on the 11AM checklist
    - SUBMISSIONS: OpenAI track added; Arduino claims the real on-device CNN;
    Espressif says held press
2026-09-20 The camera page shows the camera
    The screen drew boxes on a wash because the API had no picture to give
    it: the worker held every pixel and nothing crossed a socket. That is
    relaxed here, deliberately. The hub posts the same annotated frame it
    draws in its own window, the API holds exactly one per camera in RAM,
    and the app pulls it five times a second. The page is the picture, the
    sentence burned under it, one line about what that costs, and Pause.
    What is still true, and what the new tests pin: no frame is written to
    disk on either side (the AST ban on imwrite/VideoWriter is untouched;
    this encodes to memory), nothing reaches Mongo, a paused or unconsented
    camera can neither post a frame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
2026-09-20 demo_reset.sh: 15-second clean slate between judges (acks alerts, reseeds, keeps fingerprints)
2026-09-20 The console says what the hub window says, with room to say it
    Proportions first. The picture was cropped by `cover` and then had a
    third of its height covered by a caption bar burned across the bottom,
    which on a camera page is the one thing that must not happen quietly.
    The frame is `contain` now, so a webcam that hands over 4:3 keeps its
    sides, and the sentence reads under the pane at full width instead of
    clamped to two lines over the room. Only the REC light stays on the
    picture, and it carries its own ground.
    Then the readings. "Sitting" on its own was the whole answer; the hub's
    own window has had posture, the food and dish words, the seating and
    the state all along. They are on the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
2026-09-20 Highlights, off the same values the window prints
    Three headed tables said what eight highlights say, over a screen and a
    half of scrolling. One plate now: posture, activity, eating, where,
    people, seating, food, dishes, two to a row, with the worker's own state
    (gate, confidence, tick age, model) on one quiet line under it. Nothing
    was dropped, it just stopped being a report.
    Accuracy is now structural rather than careful. `Worker._readings()` is
    the single dict the hub's overlay and the monitor tick both render, so
    the phone and the screen on the hub cannot disagree about what the
    worker believes. It also holds the last words between detector runs:
    `self.scene` is reset every sampled fram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
2026-09-20 One switch on the camera page, and it says what it does
    The page offered "Pause for 2 hours", which is the mechanism, not the
    thing a person wants. It is a switch now: Turn the camera off, Turn the
    camera on, with the line above it saying when it comes back.
    "Off" is still the pause underneath, and the switch does not pretend
    otherwise: the API caps a pause at 24 hours and the camera coming back
    by itself is a safety property, not an oversight, because a camera
    nobody remembers to turn on is the failure this product cannot have.
    The stamp is day-aware now (`whenOf`) — "9:12 AM" is a lie about a time
    twenty-four hours out.
    Her own pause is not offered here at all. §8.3 says the family ca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
2026-09-20 Four screens: a dashboard, a calendar, a search, and a settings that fits
    Today is a board. Her name and the camera's sentence on the one focal
    plate, Call directly under it as the only accent control on the screen,
    then the four figures as separate tiles under a rule, then the camera's
    own state, then the occasional rows. The first four panels land inside
    one screen, so the important half needs no scroll. Nothing new is
    displayed: every value is the same server field it was, both staleness
    gates and the missing-value glyph are untouched, and nothing invented a
    sparkline out of numbers the server does not send.
    Her day is a calendar, because it always was one. A month heading and a
    week str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
    [beacon.ino]
2026-09-20 The switch on the camera page actually opens the camera
    It used to pause and resume a worker somebody had already started by
    hand. It now starts and stops the worker process itself: On opens the
    webcam on the machine running the API, loads the models and begins the
    cascade; Off ends the process, so the device is released and the light
    on her laptop goes out. A switch that only stopped a screen from drawing
    would be the worst lie this product could tell.
    Read the notice at the top of app/vision_control.py before touching it.
    This is an HTTP route that turns on a camera in someone's home, on a
    build with no auth, so anything on the network can press it. What keeps
    it survivable: the command i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
2026-09-20 The camera feed runs at the camera's rate, not a third of it
    Measured first, because "link it directly" assumes the hop is the cost
    and it is not: one GET of the latest frame is 0.7-1.0 ms median on the
    loopback. There is nothing in that path worth removing. The lag was
    three throttles of my own, in series.
    * The worker encoded at 5 fps (`_stream` capped at 0.2 s).
    * The app asked at 5 fps (a 200 ms poll).
    * And the relay was skipped for every UNSAMPLED frame: the cascade
    runs on every second frame on purpose, and the `continue` that
    implements that took the phone with it. The window beside it was
    already fixed for exactly this reason and says so in a comment two
    lines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
2026-09-20 One script to check the demo, and a runbook that matches it
    `./demo.sh check` answers "am I ready" in ten lines: hub, tunnel, keys,
    board wifi, fingerprint count, camera warmth, and whether an alert is
    still open. Every check in it is a thing that actually went wrong this
    morning, not a thing that might: the board sitting on an SSID with no
    route off it, ngrok dying with the API because `lsof -ti:8000` matches
    the tunnel too, an alert left mid-ladder so the app opens on a takeover.
    The tunnel check tries three times before it calls anything down. The
    free tunnel over venue wifi answers about four times in five at 1-5 s,
    measured, and a check that cries wolf gets ignored at the worst moment.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
2026-09-20 The simulated band's fingerprints match its own scans again
    _scan_vector now keys every beacon as uuid:major:minor, because a site's
    anchors all share the site uuid and the identity lives in major/minor. The
    simulator was still writing its fingerprint under the bare uuid, so the key
    it stored and the key it posted could never match: the walk demo scanned,
    matched nothing, and sat at location_unknown forever.
    Three fixtures carried the same pre-major/minor shape and failed for the
    same reason, not because the new keying is wrong.
